joerdsonsilva/cryoVCO/README.md

# Cryogenic Voltage-Controlled Oscillator (VCO)

Currently, the classical electronics used for qubit control and readout operates at room temperature, while the qubits operate at cryogenic temperatures. This temperature difference requires connections between different thermal stages, which can limit the scalability of quantum computers. Accordingly, this project aims to develop a voltage-controlled oscillator (VCO) using a cross-coupled LC topology, capable of operating at cryogenic temperatures of 4 K (or −269 °C) for future applications in superconducting qubit control.

The LC-VCO schematic was implemented in the Cadence Virtuoso environment, using the technology available in the SG13G2 folder for room-temperature simulations. To enable operation under cryogenic conditions, transistor characterization was provided by IHP and made available in the SG13G2C folder, allowing for the analysis of device behavior at low temperatures. The schematic and the testbench were implemented according to Figures 1 and 2.

<p align="center">
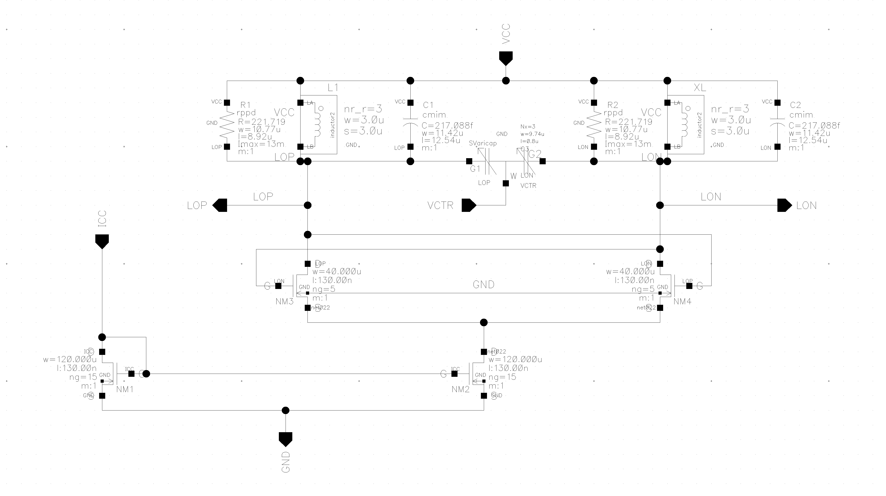
[picture p1: doc/images/Schematic.png]
Schematic
  <br>
  <em>Figure 1: LC-VCO schematic.</em>
</p>

<p align="center">
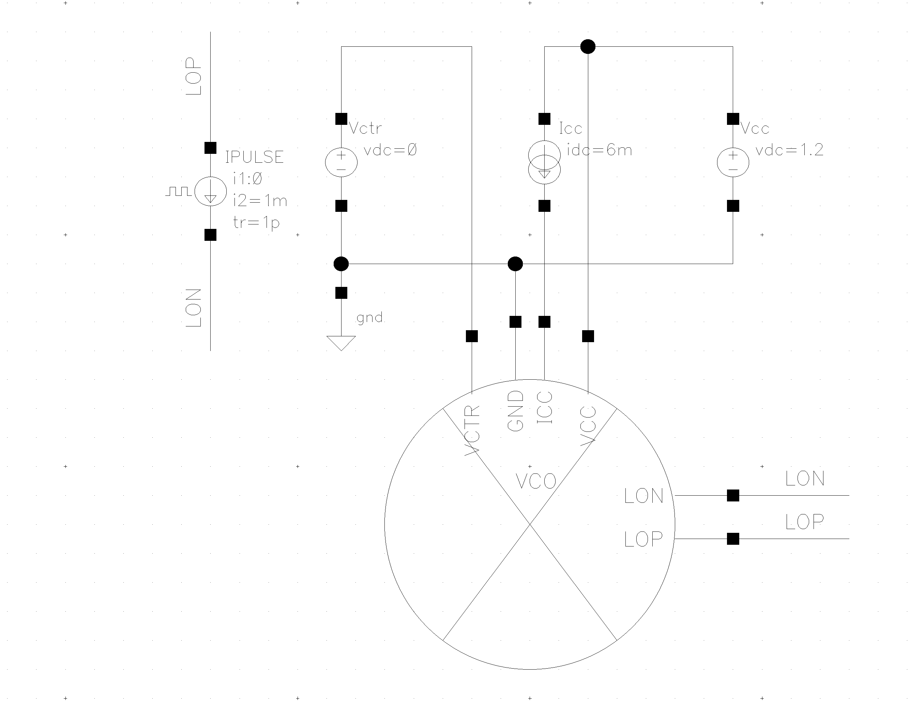
[picture p2: doc/images/Testbench.png]
Testbench
  <br>
  <em>Figure 2: Testbench setup for the LC-VCO.</em>
</p>

## Specifications

| Component  | Value | Description |
| --- | --- | --- |
| M<sub>1</sub>, M<sub>2</sub> | W/L = 120 μm / 0.13 μm | Transistor |
| M<sub>3</sub>, M<sub>4</sub> | W/L = 40 μm / 0.13 μm  | Transistor |
| C<sub>1</sub> | W/L = 9.74 μm / 0.8 μm | Varactor |
| C<sub>2</sub>, C<sub>3</sub> | 160.56 fF | Capacitor  |
| R<sub>1</sub>, R<sub>2</sub> | 221.72 Ω | Resistor |
| L<sub>1</sub>, L<sub>2</sub> | 1.54 nH | Inductor |

## Input and Output of a Cross-Coupled LC-VCO

| Pin Name | Type | Description |
| --- | --- | --- |
| VCC | Power | Power supply terminal |
| GND | Ground | Ground terminal |
| VCTR | Analog bias | Control voltage terminal | 
| ICC | Analog bias | Bias current terminal |
| LOP | Analog | Positive differential output  |
| LON | Analog | Negative differential output  |

## Parameters

| Parameter | Value (300 K) | Value (4 K) |
| --- | --- | --- |
| Technology | IHP (SG13G2) 130 nm | IHP (SG13G2C) 130 nm |
| Control Voltage | 0–3 V | 0–3 V |
| Supply Voltage | 1.2 V | 1.2 V | 
| Bias Current | ~6 mA | ~5.85 mA |

## Post-Layout Simulation

<p align="center">
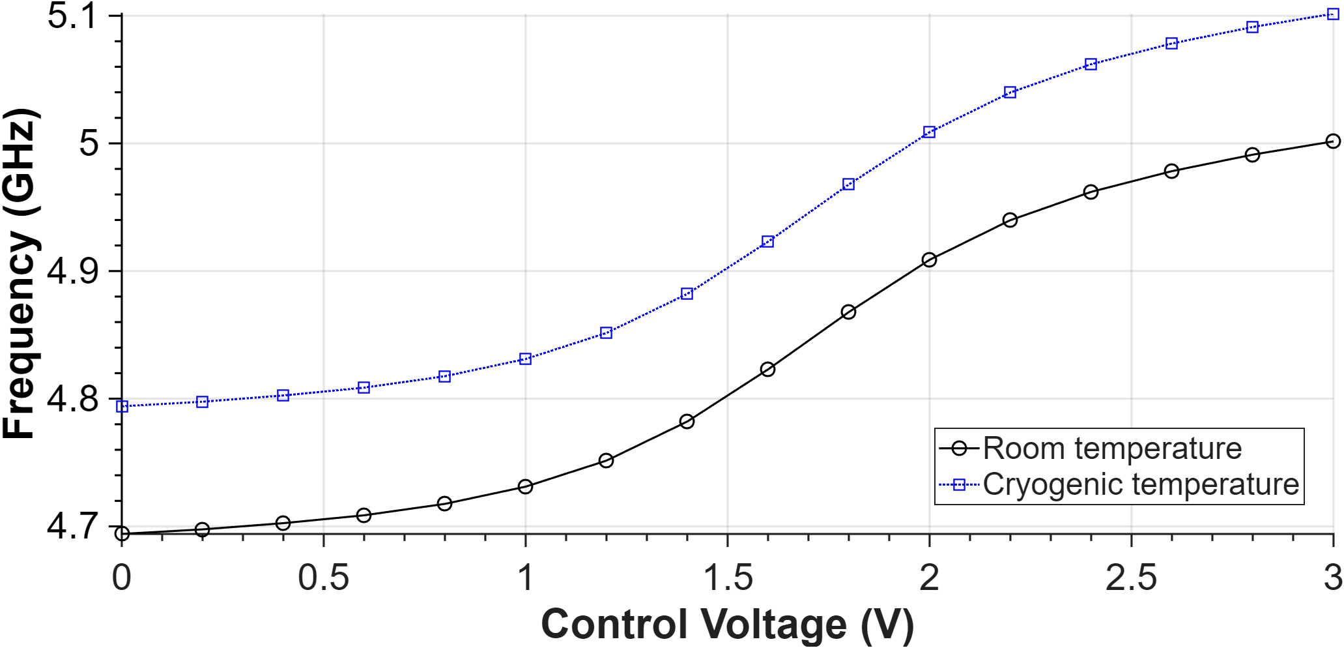
[picture p3: doc/images/Tuning Range.png]
Tuning Range
  <br>
  <em>Figure 3: Simulated oscillation frequency versus control voltage.</em>
</p>

<p align="center">
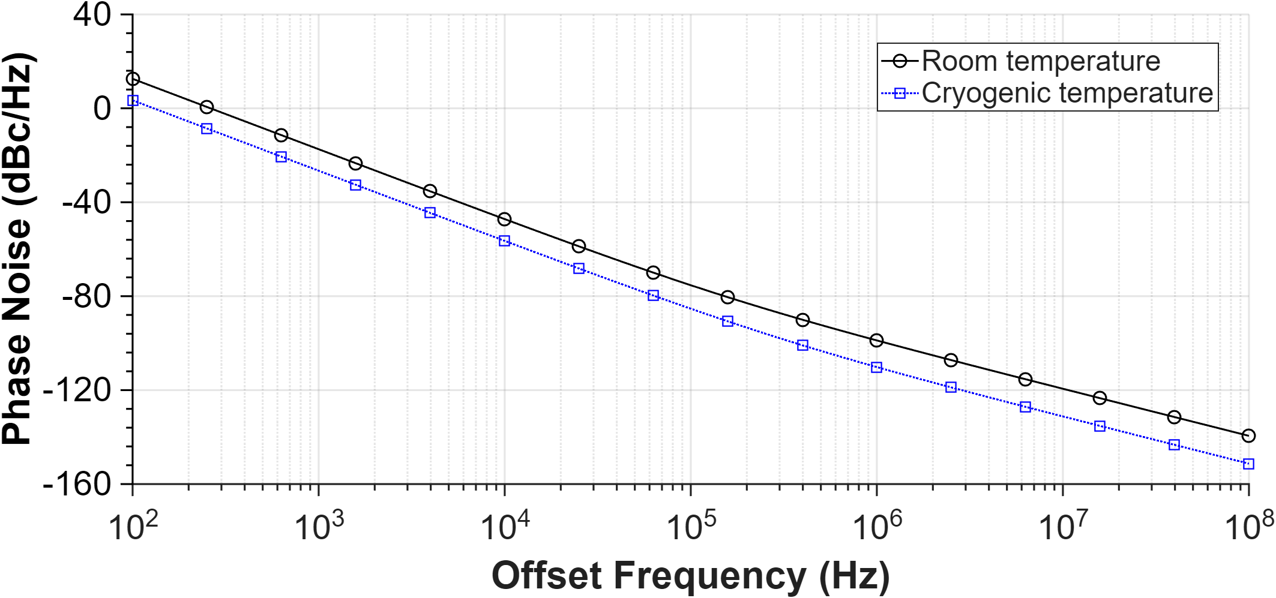
[picture p4: doc/images/Phase Noise.png]
Phase Noise
  <br>
  <em>Figure 4: Simulated phase noise at 4.9 GHz.</em>
</p>

| Parameter | Value (300 K) | Value (4 K) |
| --- | --- | --- |
| Operating Frequency  | 4.9 GHz | 4.9 GHz |
| Tuning Range | 4.7–5.0 GHz | 4.8–5.1 GHz |
| Phase Noise (@1 MHz) | -98.8 dBc/Hz  | -110 dBc/Hz |

## Layout

Below is the final completed layout of the designed circuit. 

- Dimensions: 366 µm × 231 µm
- Core Area: 0.0845 mm²

<p align="center">
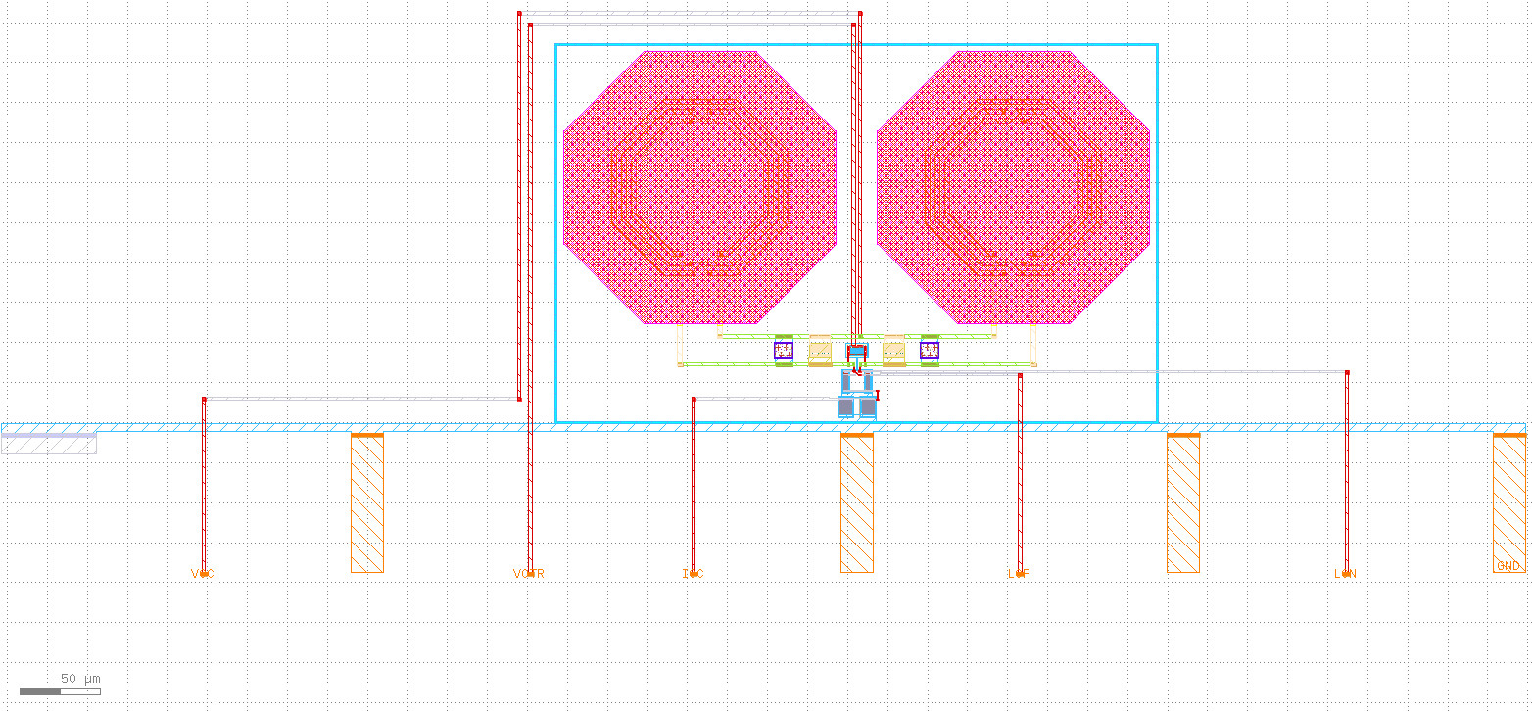
[picture p5: doc/images/Layout.png]
Layout
  <br>
  <em>Figure 5: LC-VCO Layout.</em>
</p>

The circuit includes dedicated RF pads (RFPADs) for the RF input and output connections.

<p align="center">
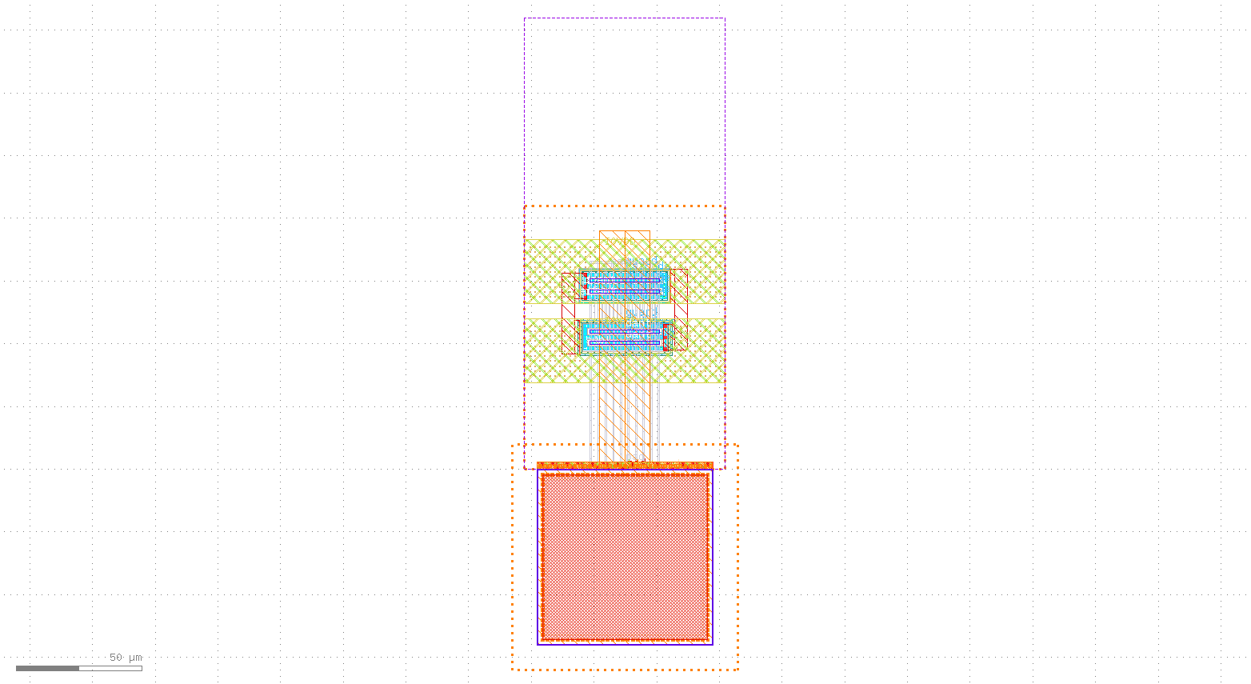
[picture p6: doc/images/RFPAD.png]
RFPAD
  <br>
  <em>Figure 6: RFPAD.</em>
</p>

## DRC and LVS Verification

The layout verification was performed using KLayout to ensure the design satisfies all design rule checks (DRC) and layout-versus-schematic (LVS) requirements.

- DRC verification: The Design Rule Check (DRC) verifies that the layout follows all the design rules defined by the PDK.

<p align="center">
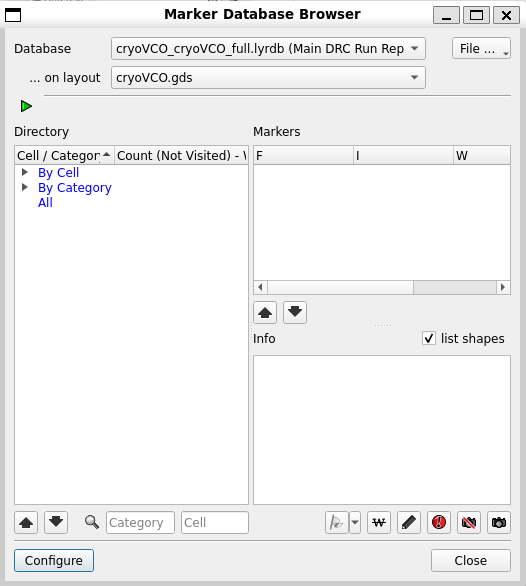
[picture p7: doc/images/DRC.png]
DRC
  <br>
  <em>Figure 7: Layout complies with design rules.</em>
</p>

- LVS verification: The Layout Versus Schematic (LVS) verification confirms that the implemented layout matches the original schematic design.

<p align="center">
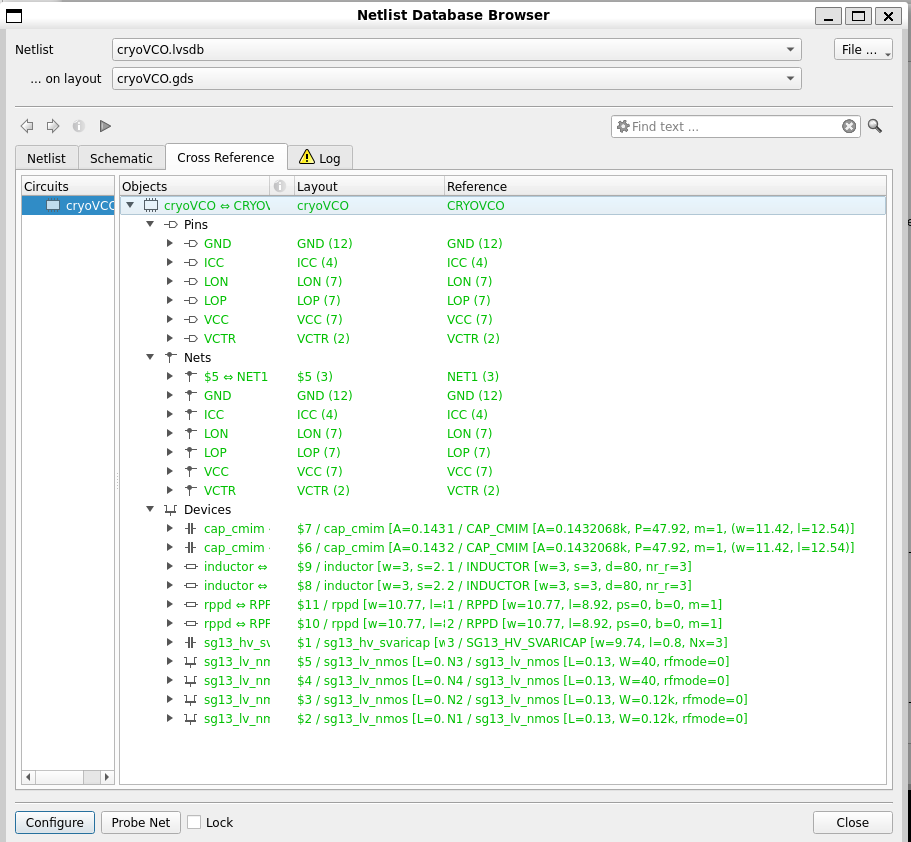
[picture p8: doc/images/LVS.png]
LVS
  <br>
  <em>Figure 8: Layout matches original schematic.</em>
</p>

## Team & Acknowledgements

This project was developed by students from the MERFESLab laboratory as part of the open-source UNIC-CASS 2025-26 program.

**Mentor**
- Prof. Francisco Brito (PhD in Electrical Engineering)
  
**Students**
  
- Joerdson Silva (MSc Student in Electrical Engineering)
- Luiz Paulo (Electrical Engineering Student)
- Iranildo Sales (Electrical Engineering Student)
